dkatsariotis/Arduino-APRS-DiGi/EasyEDA/APRS_Arduino_Tracker_Parts_List.xlsx

Name | Designator | Quantity
1μF | C1 | 1
4,7μF/16V | C2 | 1
100nF | C3 | 1
Header 4pin | J1 | 1
BS170 | Q1 | 1
100k | R1,R2 | 2
270 | R10 | 1
10k | R3,R4 | 2
8,2k | R5 | 1
3,9k | R6 | 1
2,2k | R7 | 1
1k | R8,R9 | 2
10k | RV1 | 1
SW | SW1 | 1
