dkatsariotis/Arduino-APRS-DiGi/EasyEDA/Arduino UNO APRS Case.stl

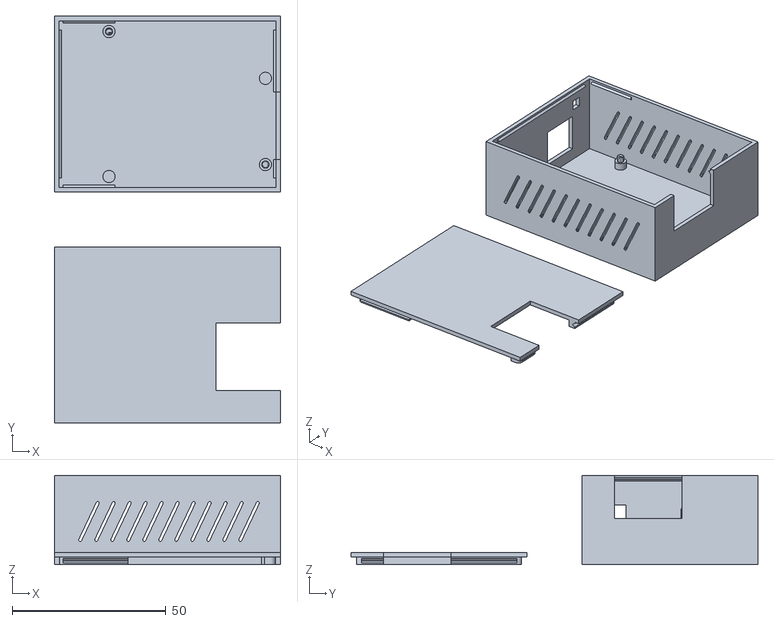
[picture p1: CAD file, 2026-11-09]
EasyEDA/Arduino UNO APRS Case.stl
73.4 x 132.1 x 29.0
