dkatsariotis/Arduino-APRS-DiGi/EasyEDA/APRS_Arduino_Tracker_Schematic.pdf

# PCB1

D13

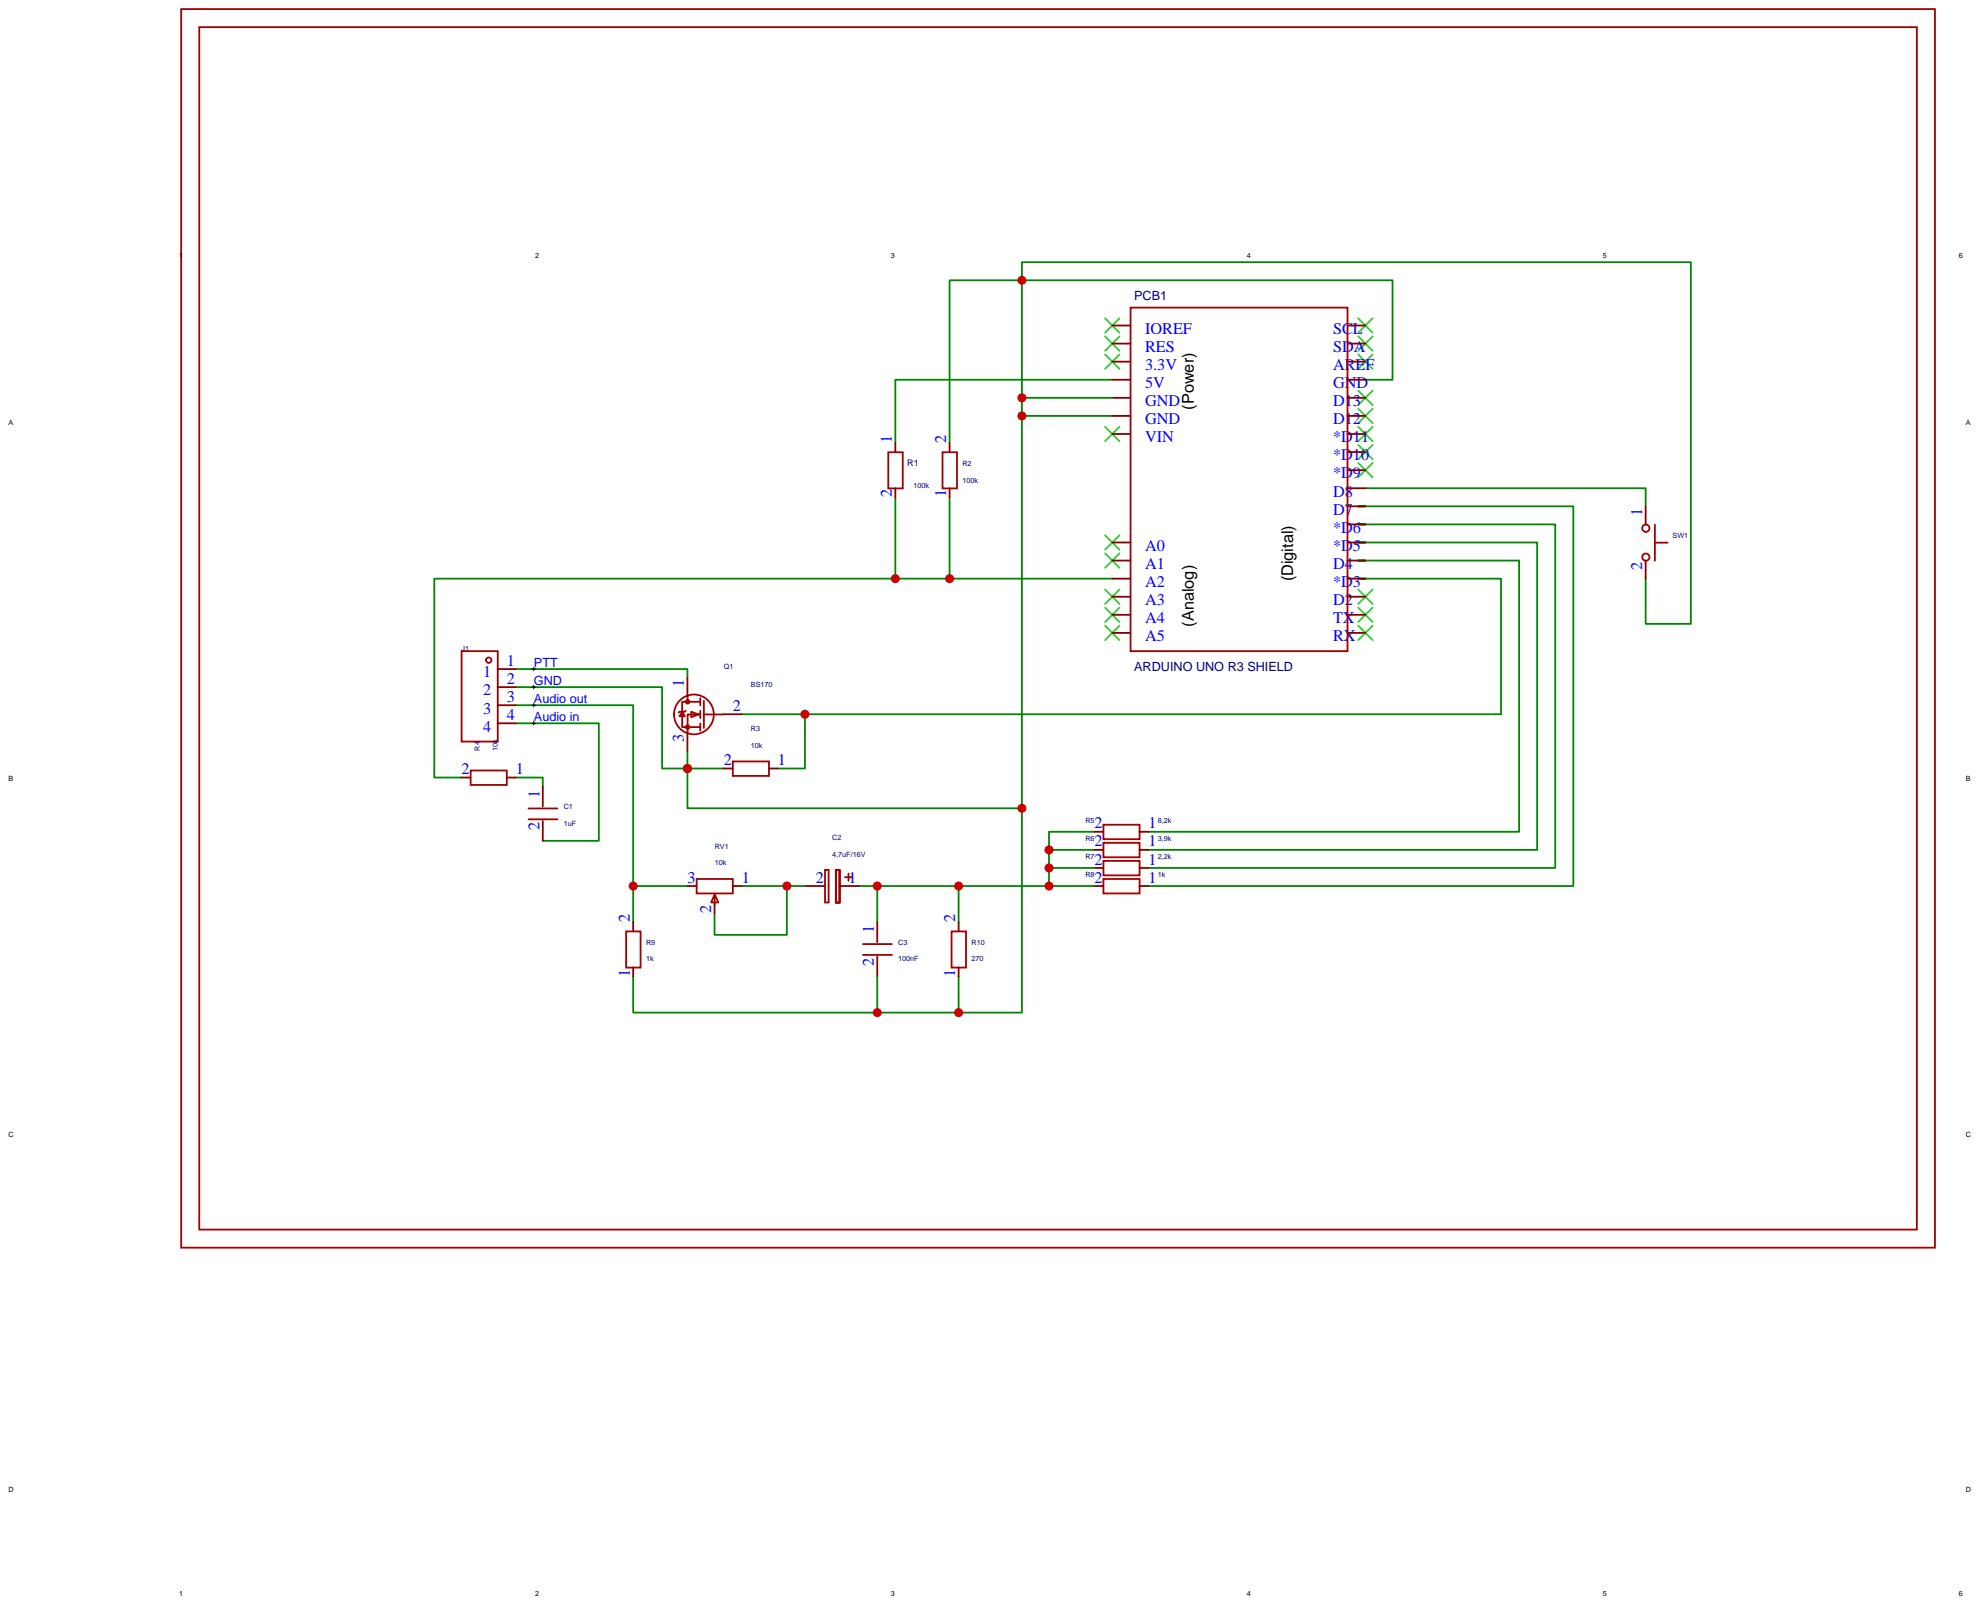
[picture p2: page 1]
