dkatsariotis/Arduino-APRS-DiGi/EasyEDA/APRS_Arduino_Tracker_PCB.pdf

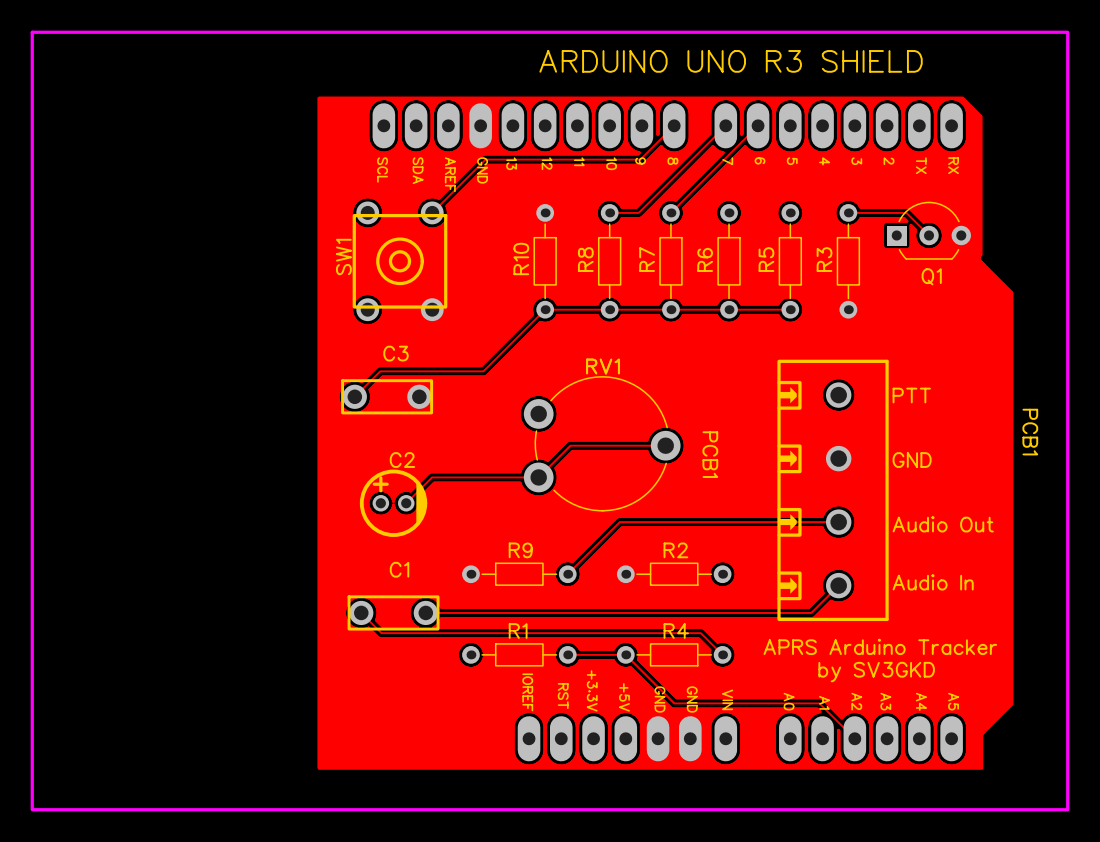
[picture p3: page 1]
