dkatsariotis/Arduino-APRS-DiGi/Software/APRS_Digi/src/LibAPRS_Digi/AFSK.cpp

#include <string.h>
#include "AFSK.h"
#include "Arduino.h"

extern unsigned long custom_preamble;
extern unsigned long custom_tail;
extern int LibAPRS_vref;
extern bool LibAPRS_open_squelch;

bool hw_afsk_dac_isr = false;
bool hw_5v_ref = false;
Afsk *AFSK_modem;

// Lightweight carrier/activity detector derived from the same ADC stream used
// by the APRS demodulator. This avoids analogRead() disturbing the 9600 Hz
// auto-triggered ADC while the receiver is active.
static volatile uint16_t afsk_dcd_hold_samples = 0;
// Separate visual hold timer: does not alter the channel-busy timing.
static volatile uint16_t afsk_rx_led_hold_samples = 0;
static int8_t afsk_dcd_state = 0;
static int16_t afsk_dcd_center = 0;
volatile int8_t afsk_rx_diag_min = 127;
volatile int8_t afsk_rx_diag_max = -128;
#define AFSK_DCD_DEADBAND 4
#define AFSK_DCD_HOLD_SAMPLES (SAMPLERATE / 20)  // ~50 ms for channel-busy logic
#define AFSK_RX_LED_HOLD_SAMPLES (SAMPLERATE / 3) // ~333 ms visible RX indication


// Forward declerations
int afsk_getchar(void);
void afsk_putchar(char c);

void AFSK_hw_refDetect(void) {
    // This is manual for now
    if (LibAPRS_vref == REF_5V) {
        hw_5v_ref = true;
    } else {
        hw_5v_ref = false;
    }
}

void AFSK_hw_init(void) {
    // Set up ADC

    AFSK_hw_refDetect();

    TCCR1A = 0;                                    
    TCCR1B = _BV(CS10) | _BV(WGM13) | _BV(WGM12);
    ICR1 = (((CPU_FREQ+FREQUENCY_CORRECTION)) / 9600) - 1;

    if (hw_5v_ref) {
        ADMUX = _BV(REFS0) | (ADC_PIN & 0x07);
    } else {

// Arduino Pro Mini 5V 16 MHz or Arduino Pro Mini 3V3 8 MHz have hardcoded the AREF to VCC
#ifdef ARDUINO_AVR_PRO
        ADMUX = _BV(REFS0) | (ADC_PIN & 0x07);
#else
        ADMUX = (ADC_PIN & 0x07);
#endif
    }

    ADC_DDR  &= ~_BV(ADC_PIN);
    ADC_PORT &= ~_BV(ADC_PIN);
    DIDR0 |= _BV(ADC_PIN);
    ADCSRB =    _BV(ADTS2) |
                _BV(ADTS1) |
                _BV(ADTS0);  
    ADCSRA =    _BV(ADEN) |
                _BV(ADSC) |
                _BV(ADATE)|
                _BV(ADIE) |
                _BV(ADPS2);

    AFSK_DAC_INIT();
    LED_TX_INIT();
    LED_RX_INIT();
}

void AFSK_init(Afsk *afsk) {
    // Allocate modem struct memory
    memset(afsk, 0, sizeof(*afsk));
    AFSK_modem = afsk;
    // Set phase increment
    afsk->phaseInc = MARK_INC;
    // Initialise FIFO buffers
    fifo_init(&afsk->delayFifo, (uint8_t *)afsk->delayBuf, sizeof(afsk->delayBuf));
    fifo_init(&afsk->rxFifo, afsk->rxBuf, sizeof(afsk->rxBuf));
    fifo_init(&afsk->txFifo, afsk->txBuf, sizeof(afsk->txBuf));

    // Fill delay FIFO with zeroes
    for (int i = 0; i<SAMPLESPERBIT / 2; i++) {
        fifo_push(&afsk->delayFifo, 0);
    }

    AFSK_hw_init();

}

static void AFSK_txStart(Afsk *afsk) {
    if (!afsk->sending) {
        afsk->phaseInc = MARK_INC;
        afsk->phaseAcc = 0;
        afsk->bitstuffCount = 0;
        afsk->sending = true;
        LED_TX_ON();
        afsk->preambleLength = DIV_ROUND(custom_preamble * BITRATE, 8000);
        AFSK_DAC_IRQ_START();
    }
    ATOMIC_BLOCK(ATOMIC_RESTORESTATE) {
      afsk->tailLength = DIV_ROUND(custom_tail * BITRATE, 8000);
    }
}

void afsk_putchar(char c) {
    AFSK_txStart(AFSK_modem);
    while(fifo_isfull_locked(&AFSK_modem->txFifo)) { /* Wait */ }
    fifo_push_locked(&AFSK_modem->txFifo, c);
}

int afsk_getchar(void) {
    if (fifo_isempty_locked(&AFSK_modem->rxFifo)) {
        return EOF;
    } else {
        return fifo_pop_locked(&AFSK_modem->rxFifo);
    }
}

void AFSK_transmit(char *buffer, size_t size) {
    fifo_flush(&AFSK_modem->txFifo);
    int i = 0;
    while (size--) {
        afsk_putchar(buffer[i++]);
    }
}

uint8_t AFSK_dac_isr(Afsk *afsk) {
    if (afsk->sampleIndex == 0) {
        if (afsk->txBit == 0) {
            if (fifo_isempty(&afsk->txFifo) && afsk->tailLength == 0) {
                AFSK_DAC_IRQ_STOP();
                afsk->sending = false;
                LED_TX_OFF();
                return 0;
            } else {
                if (!afsk->bitStuff) afsk->bitstuffCount = 0;
                afsk->bitStuff = true;
                if (afsk->preambleLength == 0) {
                    if (fifo_isempty(&afsk->txFifo)) {
                        afsk->tailLength--;
                        afsk->currentOutputByte = HDLC_FLAG;
                    } else {
                        afsk->currentOutputByte = fifo_pop(&afsk->txFifo);
                    }
                } else {
                    afsk->preambleLength--;
                    afsk->currentOutputByte = HDLC_FLAG;
                }
                if (afsk->currentOutputByte == AX25_ESC) {
                    if (fifo_isempty(&afsk->txFifo)) {
                        AFSK_DAC_IRQ_STOP();
                        afsk->sending = false;
                        LED_TX_OFF();
                        return 0;
                    } else {
                        afsk->currentOutputByte = fifo_pop(&afsk->txFifo);
                    }
                } else if (afsk->currentOutputByte == HDLC_FLAG || afsk->currentOutputByte == HDLC_RESET) {
                    afsk->bitStuff = false;
                }
            }
            afsk->txBit = 0x01;
        }

        if (afsk->bitStuff && afsk->bitstuffCount >= BIT_STUFF_LEN) {
            afsk->bitstuffCount = 0;
            afsk->phaseInc = SWITCH_TONE(afsk->phaseInc);
        } else {
            if (afsk->currentOutputByte & afsk->txBit) {
                afsk->bitstuffCount++;
            } else {
                afsk->bitstuffCount = 0;
                afsk->phaseInc = SWITCH_TONE(afsk->phaseInc);
            }
            afsk->txBit <<= 1;
        }

        afsk->sampleIndex = SAMPLESPERBIT;
    }

    afsk->phaseAcc += afsk->phaseInc;
    afsk->phaseAcc %= SIN_LEN;
    afsk->sampleIndex--;

    return sinSample(afsk->phaseAcc);
}

static bool hdlcParse(Hdlc *hdlc, bool bit, FIFOBuffer *fifo) {
    // Initialise a return value. We start with the
    // assumption that all is going to end well :)
    bool ret = true;

    // Bitshift our byte of demodulated bits to
    // the left by one bit, to make room for the
    // next incoming bit
    hdlc->demodulatedBits <<= 1;
    // And then put the newest bit from the 
    // demodulator into the byte.
    hdlc->demodulatedBits |= bit ? 1 : 0;

    // Now we'll look at the last 8 received bits, and
    // check if we have received a HDLC flag (01111110)
    if (hdlc->demodulatedBits == HDLC_FLAG) {
        // If we have, check that our output buffer is
        // not full.
        if (!fifo_isfull(fifo)) {
            // If it isn't, push the HDLC_FLAG and begin receiving data.
            // The RX monitor LED is driven independently by ADC/DCD activity.
            fifo_push(fifo, HDLC_FLAG);
            hdlc->receiving = true;
        } else {
            // If the buffer is full, we have a problem
            // and abort by setting the return value to     
            // false and stopping the here.
            
            ret = false;
            hdlc->receiving = false;
        }

        // Everytime we receive a HDLC_FLAG, we reset the
        // storage for our current incoming byte and bit
        // position in that byte. This effectively
        // synchronises our parsing to  the start and end
        // of the received bytes.
        hdlc->currentByte = 0;
        hdlc->bitIndex = 0;
        return ret;
    }

    // Check if we have received a RESET flag (01111111)
    // In this comparison we also detect when no transmission
    // (or silence) is taking place, and the demodulator
    // returns an endless stream of zeroes. Due to the NRZ
    // coding, the actual bits send to this function will
    // be an endless stream of ones, which this AND operation
    // will also detect.
    if ((hdlc->demodulatedBits & HDLC_RESET) == HDLC_RESET) {
        // If we have, something probably went wrong at the
        // transmitting end, and we abort the reception.
        // Do not touch the RX monitor LED here; it is owned by the
        // ADC/DCD activity timer, not by HDLC parser state.
        hdlc->receiving = false;
        return ret;
    }

    // If we have not yet seen a HDLC_FLAG indicating that
    // a transmission is actually taking place, don't bother
    // with anything.
    if (!hdlc->receiving)
        return ret;

    // First check if what we are seeing is a stuffed bit.
    // Since the different HDLC control characters like
    // HDLC_FLAG, HDLC_RESET and such could also occur in
    // a normal data stream, we employ a method known as
    // "bit stuffing". All control characters have more than
    // 5 ones in a row, so if the transmitting party detects
    // this sequence in the _data_ to be transmitted, it inserts
    // a zero to avoid the receiving party interpreting it as
    // a control character. Therefore, if we detect such a
    // "stuffed bit", we simply ignore it and wait for the
    // next bit to come in.
    // 
    // We do the detection by applying an AND bit-mask to the
    // stream of demodulated bits. This mask is 00111111 (0x3f)
    // if the result of the operation is 00111110 (0x3e), we
    // have detected a stuffed bit.
    if ((hdlc->demodulatedBits & 0x3f) == 0x3e)
        return ret;

    // If we have an actual 1 bit, push this to the current byte
    // If it's a zero, we don't need to do anything, since the
    // bit is initialized to zero when we bitshifted earlier.
    if (hdlc->demodulatedBits & 0x01)
        hdlc->currentByte |= 0x80;

    // Increment the bitIndex and check if we have a complete byte
    if (++hdlc->bitIndex >= 8) {
        // If we have a HDLC control character, put a AX.25 escape
        // in the received data. We know we need to do this,
        // because at this point we must have already seen a HDLC
        // flag, meaning that this control character is the result
        // of a bitstuffed byte that is equal to said control
        // character, but is actually part of the data stream.
        // By inserting the escape character, we tell the protocol
        // layer that this is not an actual control character, but
        // data.
        if ((hdlc->currentByte == HDLC_FLAG ||
             hdlc->currentByte == HDLC_RESET ||
             hdlc->currentByte == AX25_ESC)) {
            // We also need to check that our received data buffer
            // is not full before putting more data in
            if (!fifo_isfull(fifo)) {
                fifo_push(fifo, AX25_ESC);
            } else {
                // If it is, abort and return false
                hdlc->receiving = false;
                    ret = false;
            }
        }

        // Push the actual byte to the received data FIFO,
        // if it isn't full.
        if (!fifo_isfull(fifo)) {
            fifo_push(fifo, hdlc->currentByte);
        } else {
            // If it is, well, you know by now!
            hdlc->receiving = false;
            ret = false;
        }

        // Wipe received byte and reset bit index to 0
        hdlc->currentByte = 0;
        hdlc->bitIndex = 0;

    } else {
        // We don't have a full byte yet, bitshift the byte
        // to make room for the next bit
        hdlc->currentByte >>= 1;
    }

    //digitalWrite(13, LOW);
    return ret;
}


void AFSK_adc_isr(Afsk *afsk, int8_t currentSample) {
    // To determine the received frequency, and thereby
    // the bit of the sample, we multiply the sample by
    // a sample delayed by (samples per bit / 2).
    // We then lowpass-filter the samples with a
    // Chebyshev filter. The lowpass filtering serves
    // to "smooth out" the variations in the samples.

    afsk->iirX[0] = afsk->iirX[1];
    afsk->iirX[1] = ((int8_t)fifo_pop(&afsk->delayFifo) * currentSample) >> 2;

    afsk->iirY[0] = afsk->iirY[1];
    
    afsk->iirY[1] = afsk->iirX[0] + afsk->iirX[1] + (afsk->iirY[0] >> 1); // Chebyshev filter


    // We put the sampled bit in a delay-line:
    // First we bitshift everything 1 left
    afsk->sampledBits <<= 1;
    // And then add the sampled bit to our delay line
    afsk->sampledBits |= (afsk->iirY[1] > 0) ? 1 : 0;

    // Put the current raw sample in the delay FIFO
    fifo_push(&afsk->delayFifo, currentSample);

    // We need to check whether there is a signal transition.
    // If there is, we can recalibrate the phase of our 
    // sampler to stay in sync with the transmitter. A bit of
    // explanation is required to understand how this works.
    // Since we have PHASE_MAX/PHASE_BITS = 8 samples per bit,
    // we employ a phase counter (currentPhase), that increments
    // by PHASE_BITS everytime a sample is captured. When this
    // counter reaches PHASE_MAX, it wraps around by modulus
    // PHASE_MAX. We then look at the last three samples we
    // captured and determine if the bit was a one or a zero.
    //
    // This gives us a "window" looking into the stream of
    // samples coming from the ADC. Sort of like this:
    //
    //   Past                                      Future
    //       0000000011111111000000001111111100000000
    //                   |________|
    //                       ||     
    //                     Window
    //
    // Every time we detect a signal transition, we adjust
    // where this window is positioned little. How much we
    // adjust it is defined by PHASE_INC. If our current phase
    // phase counter value is less than half of PHASE_MAX (ie, 
    // the window size) when a signal transition is detected,
    // add PHASE_INC to our phase counter, effectively moving
    // the window a little bit backward (to the left in the
    // illustration), inversely, if the phase counter is greater
    // than half of PHASE_MAX, we move it forward a little.
    // This way, our "window" is constantly seeking to position
    // it's center at the bit transitions. Thus, we synchronise
    // our timing to the transmitter, even if it's timing is
    // a little off compared to our own.
    if (SIGNAL_TRANSITIONED(afsk->sampledBits)) {
        if (afsk->currentPhase < PHASE_THRESHOLD) {
            afsk->currentPhase += PHASE_INC;
        } else {
            afsk->currentPhase -= PHASE_INC;
        }
    }

    // We increment our phase counter
    afsk->currentPhase += PHASE_BITS;

    // Check if we have reached the end of
    // our sampling window.
    if (afsk->currentPhase >= PHASE_MAX) {
        // If we have, wrap around our phase
        // counter by modulus
        afsk->currentPhase %= PHASE_MAX;

        // Bitshift to make room for the next
        // bit in our stream of demodulated bits
        afsk->actualBits <<= 1;

        // We determine the actual bit value by reading
        // the last 3 sampled bits. If there is three or
        // more 1's, we will assume that the transmitter
        // sent us a one, otherwise we assume a zero
        uint8_t bits = afsk->sampledBits & 0x07;
        if (bits == 0x07 || // 111
            bits == 0x06 || // 110
            bits == 0x05 || // 101
            bits == 0x03    // 011
            ) {
            afsk->actualBits |= 1;
        }

         //// Alternative using five bits ////////////////
         // uint8_t bits = afsk->sampledBits & 0x0f;
         // uint8_t c = 0;
         // c += bits & BV(1);
         // c += bits & BV(2);
         // c += bits & BV(3);
         // c += bits & BV(4);
         // c += bits & BV(5);
         // if (c >= 3) afsk->actualBits |= 1;
        /////////////////////////////////////////////////

        // Now we can pass the actual bit to the HDLC parser.
        // We are using NRZ coding, so if 2 consecutive bits
        // have the same value, we have a 1, otherwise a 0.
        // We use the TRANSITION_FOUND function to determine this.
        //
        // This is smart in combination with bit stuffing,
        // since it ensures a transmitter will never send more
        // than five consecutive 1's. When sending consecutive
        // ones, the signal stays at the same level, and if
        // this happens for longer periods of time, we would
        // not be able to synchronize our phase to the transmitter
        // and would start experiencing "bit slip".
        //
        // By combining bit-stuffing with NRZ coding, we ensure
        // that the signal will regularly make transitions
        // that we can use to synchronize our phase.
        //
        // We also check the return of the Link Control parser
        // to check if an error occured.

        if (!hdlcParse(&afsk->hdlc, !TRANSITION_FOUND(afsk->actualBits), &afsk->rxFifo)) {
            afsk->status |= 1;
            if (fifo_isfull(&afsk->rxFifo)) {
                fifo_flush(&afsk->rxFifo);
                afsk->status = 0;
            }
        }
    }

}

bool AFSK_channelBusy(void) {
    uint16_t hold_samples;
    bool receiving;
    ATOMIC_BLOCK(ATOMIC_RESTORESTATE) {
        hold_samples = afsk_dcd_hold_samples;
        receiving = (AFSK_modem != NULL && AFSK_modem->hdlc.receiving);
    }
    return (hold_samples > 0) || receiving;
}

void AFSK_abortTx(Afsk *afsk) {
    if (afsk == NULL) return;

    ATOMIC_BLOCK(ATOMIC_RESTORESTATE) {
        AFSK_DAC_IRQ_STOP();
        fifo_flush(&afsk->txFifo);
        afsk->sending = false;
        afsk->preambleLength = 0;
        afsk->tailLength = 0;
        afsk->txBit = 0;
        afsk->bitStuff = false;
        afsk->bitstuffCount = 0;
    }
    LED_TX_OFF();
}

void AFSK_flushRx(Afsk *afsk) {
    ATOMIC_BLOCK(ATOMIC_RESTORESTATE) {
        fifo_flush(&afsk->rxFifo);
        memset(&afsk->hdlc, 0, sizeof(afsk->hdlc));

        // Reset the discriminator/clock recovery state as well. This is used
        // after our own transmission so self-audio does not leak into the
        // next received frame.
        fifo_init(&afsk->delayFifo, (uint8_t *)afsk->delayBuf, sizeof(afsk->delayBuf));
        for (uint8_t i = 0; i < SAMPLESPERBIT / 2; ++i) {
            fifo_push(&afsk->delayFifo, 0);
        }
        memset(afsk->iirX, 0, sizeof(afsk->iirX));
        memset(afsk->iirY, 0, sizeof(afsk->iirY));
        afsk->sampledBits = 0;
        afsk->currentPhase = 0;
        afsk->actualBits = 0;
        afsk->status = 0;

        afsk_dcd_hold_samples = 0;
        afsk_rx_led_hold_samples = 0;
        afsk_dcd_state = 0;
        afsk_dcd_center = 0;
        LED_RX_OFF();
    }
}

ISR(ADC_vect) {
    TIFR1 = _BV(ICF1);

    int8_t sample = ((int16_t)(ADC >> 2) - 128);

     // RX audio diagnostics
    if (sample < afsk_rx_diag_min) afsk_rx_diag_min = sample;
    if (sample > afsk_rx_diag_max) afsk_rx_diag_max = sample;

    // Count meaningful crossings around a slowly moving DC centre. This is
    // the ISR-safe equivalent of the adaptive centre used in the working
    // the ISR-safe equivalent of the adaptive centre used in the working
    // tracker carrier detector, and tolerates modest A2 bias offsets.
    afsk_dcd_center += ((int16_t)sample - afsk_dcd_center) >> 4;
    int16_t dcd_delta = (int16_t)sample - afsk_dcd_center;

    // Any recent activity holds DCD busy briefly. Voice/noise also blocks TX,
    // which is desirable for listen-before-transmit on the APRS channel.
    int8_t new_state = afsk_dcd_state;
    if (dcd_delta > AFSK_DCD_DEADBAND) {
        new_state = 1;
    } else if (dcd_delta < -AFSK_DCD_DEADBAND) {
        new_state = -1;
    }

    if (afsk_dcd_state != 0 && new_state != 0 && new_state != afsk_dcd_state) {
        afsk_dcd_hold_samples = AFSK_DCD_HOLD_SAMPLES;
        // Any meaningful audio crossing lights the external RX monitor LED.
        // A separate 333 ms hold makes activity visible without changing DCD.
        afsk_rx_led_hold_samples = AFSK_RX_LED_HOLD_SAMPLES;
        LED_RX_ON();
    }
    if (new_state != 0) {
        afsk_dcd_state = new_state;
    }
    if (afsk_dcd_hold_samples > 0) {
        afsk_dcd_hold_samples--;
    }
    if (afsk_rx_led_hold_samples > 0) {
        afsk_rx_led_hold_samples--;
        if (afsk_rx_led_hold_samples == 0) {
            LED_RX_OFF();
        }
    }

    AFSK_adc_isr(AFSK_modem, sample);

    // D4-D7 are the 4-bit DAC. Preserve D0-D3 so UART pins and the
    // sketch-controlled PTT on D3 are never overwritten by the ISR.
    uint8_t low_nibble = DAC_PORT & 0x0F;
    if (hw_afsk_dac_isr) {
        DAC_PORT = low_nibble | (AFSK_dac_isr(AFSK_modem) & 0xF0);
    } else {
        DAC_PORT = low_nibble | 0x80;
    }
}


void AFSK_getRxLevel(int8_t *minVal, int8_t *maxVal)
{
    ATOMIC_BLOCK(ATOMIC_RESTORESTATE) {
        *minVal = afsk_rx_diag_min;
        *maxVal = afsk_rx_diag_max;

        afsk_rx_diag_min = 127;
        afsk_rx_diag_max = -128;
    }
}
