dkatsariotis/Arduino-APRS-DiGi/Software/APRS_Digi/10_radio.ino

// -----------------------------------------------------------------------------
// Radio / PTT / clear-channel / TX safety
// -----------------------------------------------------------------------------

void forcePttOff() {
  pinMode(PTT_PIN, OUTPUT);
  digitalWrite(PTT_PIN, PTT_ACTIVE_HIGH ? LOW : HIGH);
}

void forcePttOn() {
  // Last-line safety interlock: no caller can key the radio in MONITOR_ONLY.
  if (!modeAllowsTransmit()) {
    forcePttOff();
    return;
  }
  pinMode(PTT_PIN, OUTPUT);
  digitalWrite(PTT_PIN, PTT_ACTIVE_HIGH ? HIGH : LOW);
}

bool waitForClearChannel(unsigned long maxWaitMs, bool preserveRxFrame) {
  if (!CHANNEL_BUSY_DETECT_ENABLED) return true;

  unsigned long started = millis();
  unsigned long clearSince = 0;

  while (true) {
    if (ENABLE_WATCHDOG) wdt_reset();

    // For local beacons, keep decoding while waiting. If an eligible RF relay
    // arrives, abort the local beacon so the relay gets priority. For a pending
    // relay, do not call APRS_poll(): its info pointer refers to the current
    // AX25 RX buffer and must remain untouched until TX/drop.
    if (!preserveRxFrame) {
      APRS_poll();
      if (relayPending) return false;
    }

    if (!APRS_channelBusy()) {
      if (clearSince == 0) {
        clearSince = millis();
      }
      if ((unsigned long)(millis() - clearSince) >= CHANNEL_CLEAR_HOLD_MS) {
        return true;
      }
    } else {
      clearSince = 0;
    }

    if ((unsigned long)(millis() - started) >= maxWaitMs) {
      return false;
    }

    delay(2);
  }
}

bool transmitFrame(const AX25Call *path, uint8_t pathLen, uint8_t repeatedMask,
                   const uint8_t *info, uint16_t infoLen,
                   unsigned long maxChannelWaitMs, bool preserveRxFrame) {
  // Central TX gate protects every packet source (relay, beacon or button).
  if (!modeAllowsTransmit()) {
    forcePttOff();
    return false;
  }
  if (path == NULL || pathLen < 2 || info == NULL || infoLen == 0) {
    return false;
  }
  if (radioTxActive || APRS_isSending()) {
    return false;
  }

  radioTxActive = true;

  if (!waitForClearChannel(maxChannelWaitMs, preserveRxFrame)) {
    forcePttOff();
    radioTxActive = false;
    return false;
  }

  forcePttOn();

  // Preserve the working tracker's pre-key behavior. The patched AFSK ISR
  // now preserves D3, so this delay really does keep PTT asserted before AFSK.
  unsigned long keyStart = millis();
  while ((unsigned long)(millis() - keyStart) < RADIO_KEYUP_MS) {
    if (ENABLE_WATCHDOG) wdt_reset();
    delay(2);
  }

  unsigned long txStarted = millis();
  bool timedOut = false;

  APRS_sendViaH(path, pathLen, repeatedMask, info, infoLen);

  while (APRS_isSending() || (unsigned long)(millis() - txStarted) < TX_MIN_TOTAL_MS) {
    if (ENABLE_WATCHDOG) wdt_reset();

    if ((unsigned long)(millis() - txStarted) > TX_TIMEOUT_MS) {
      timedOut = true;
      break;
    }
    delay(2);
  }

  if (timedOut) {
    // A timeout can leave the modem's sending flag/FIFO latched. Abort the
    // low-level AFSK transmitter before returning so future beacons/relays are
    // not permanently blocked by APRS_isSending().
    APRS_abortTransmit();
    STAT_INC(txTimeouts);
  }

  delay(TX_POST_HOLD_MS);
  forcePttOff();

  // Discard any self-audio/garbage accumulated by the RX path during TX.
  APRS_resetReceiver();
  radioTxActive = false;

  if (timedOut) {
    DBG_PRINTLN(F("TX ERROR: timeout, modem aborted, PTT forced OFF"));
    return false;
  }

  return true;
}
