dkatsariotis/Arduino-APRS-DiGi/(commit log)

2026-11-09 Fix Arduino prototype ordering for digipeater types
2026-11-09 3D case
